Stapelzeiger/airdata-probe/Readme.md

# Airdata Probe

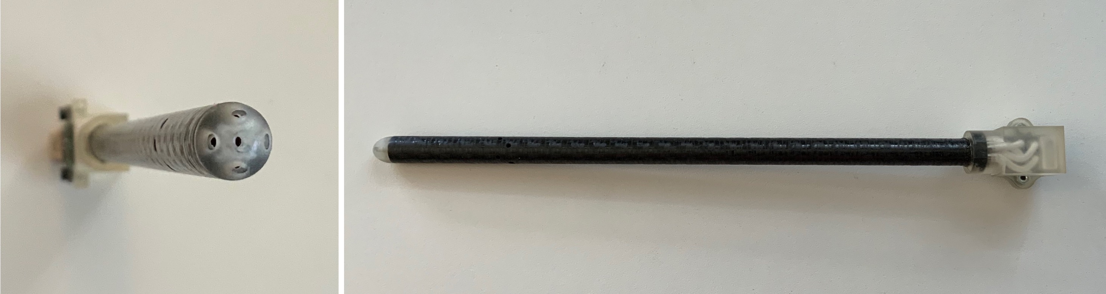
[picture p1: pictures/top_side.jpg]
Side view


## Ports

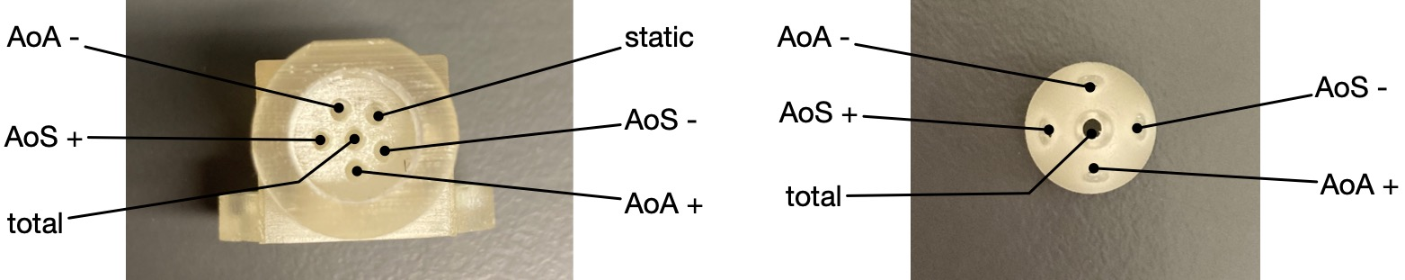
[picture p2: pictures/ports.jpg]
ports


## PCB

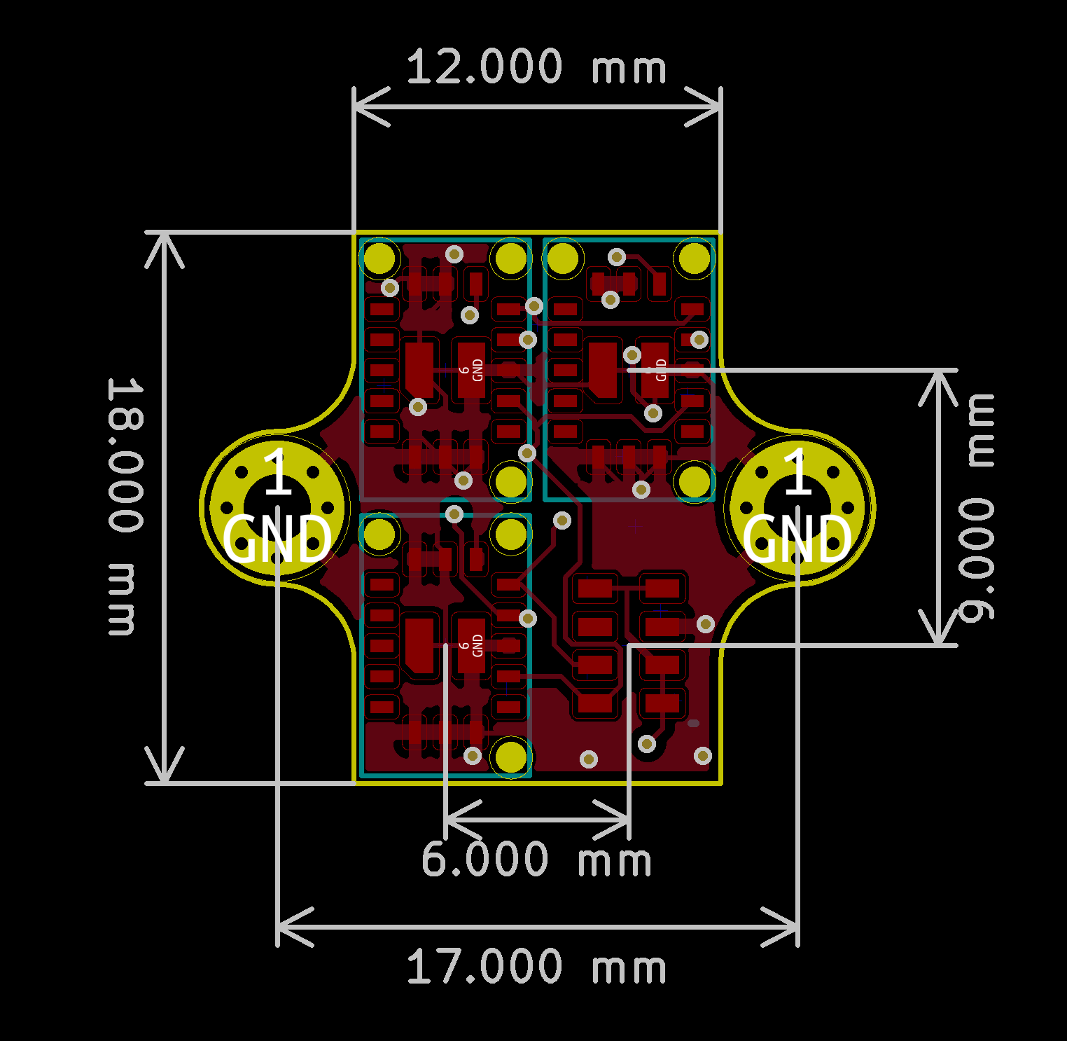
[picture p3: pcb/dimensions.png]
PCB


[Schematic](pcb/airdata.pdf)
