Stapelzeiger/airdata-probe/cad/parts.txt

Stainless Steel Tubing, 304 Stainless Steel, 0.072" OD, 0.005" Wall Thickness, 1 Foot Long 5560K36 https://www.mcmaster.com/nav/enter.asp?partnum=5560K36

o-ring https://www.mcmaster.com/9452K311/

Tygon PVC Clear Tubing 1/16" ID, 1/8" OD, 25 ft. Length 6516T11 https://www.mcmaster.com/nav/enter.asp?partnum=6516T11

Carbon Fiber Roll Wrapped Twill Tube ~ 0.313" ID x 24", Thin Wall Gloss Finish
https://dragonplate.com/carbon-fiber-roll-wrapped-twill-tube-0313-id-x-24-thin-wall-gloss-finish

Carbon Fiber Roll Wrapped Twill Tube ~ 0.25" ID x 24", Thin Wall Gloss Finish
https://dragonplate.com/carbon-fiber-roll-wrapped-twill-tube-025-id-x-24-thin-wall-gloss-finish
