Stapelzeiger/airdata-probe/cad/pressure_board.SLDASM

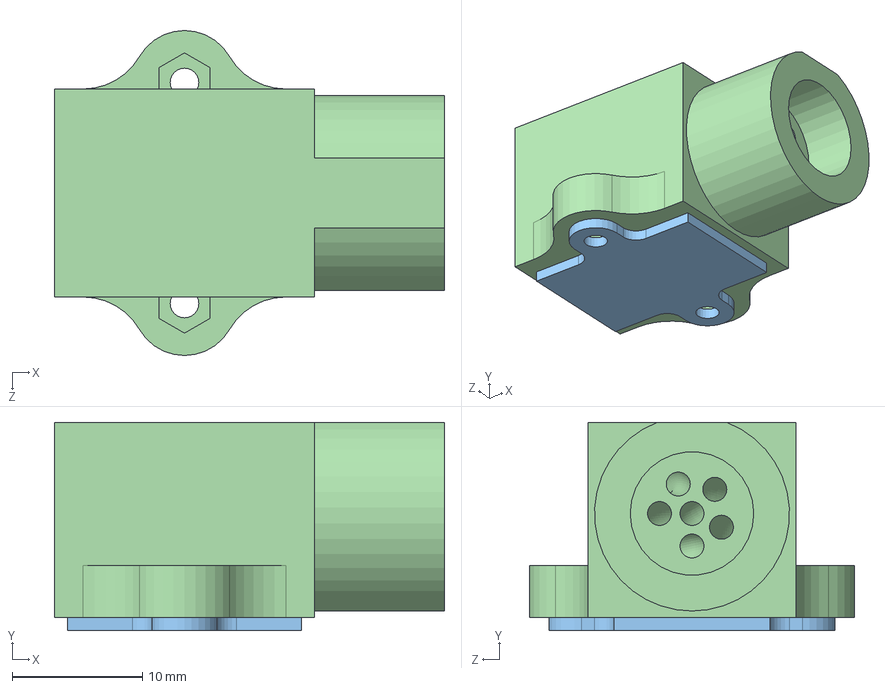
[picture p4: CAD file, 2022-06-05]
cad/pressure_board.SLDASM
30.0 x 16.0 x 25.0 mm
sdp3x x 3
static_pressure_connector
PCB^pressure_board
Part2^pressure_board
