Stapelzeiger/airdata-probe/cad/flow-sensor.SLDASM

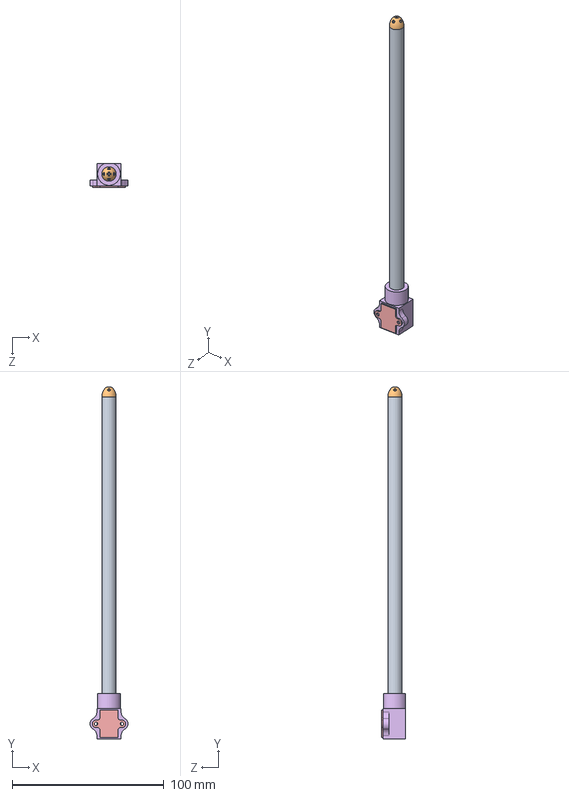
[picture p5: CAD file, 2022-06-05]
cad/flow-sensor.SLDASM
25.0 x 231.7 x 16.0 mm
flow-sensor-tube
flow-sensor-tip
sdp3x x 3
static_pressure_connector
PCB^pressure_board
Part2^pressure_board
