Stapelzeiger/airdata-probe/cad/static_pressure_connector.SLDPRT

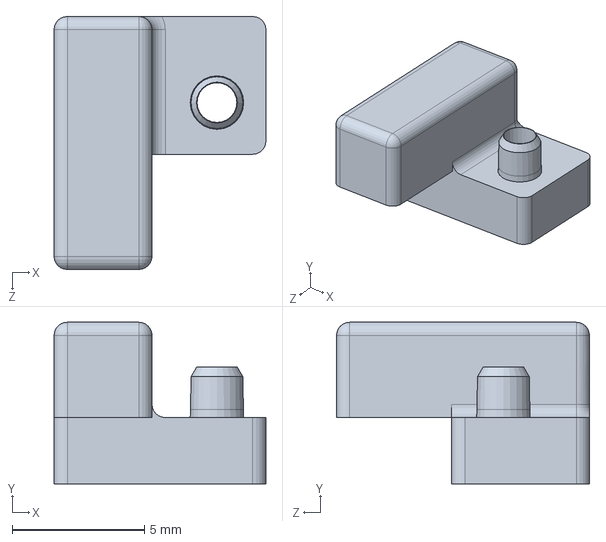
[picture p6: CAD file, 2022-06-05]
cad/static_pressure_connector.SLDPRT
8.00 x 6.10 x 9.55 mm
