Stapelzeiger/airdata-probe/pcb/3dmodels/SM04B-GHS-TB.stp

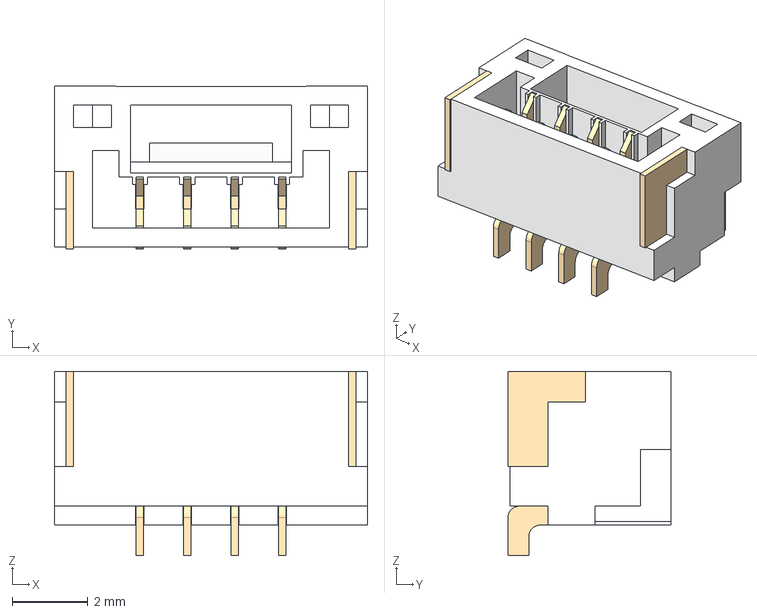
[picture p7: CAD file, 2022-06-05]
pcb/3dmodels/SM04B-GHS-TB.stp
8.25 x 4.30 x 4.85 mm
