Stapelzeiger/airdata-probe/cad/flow-sensor-tip.SLDPRT

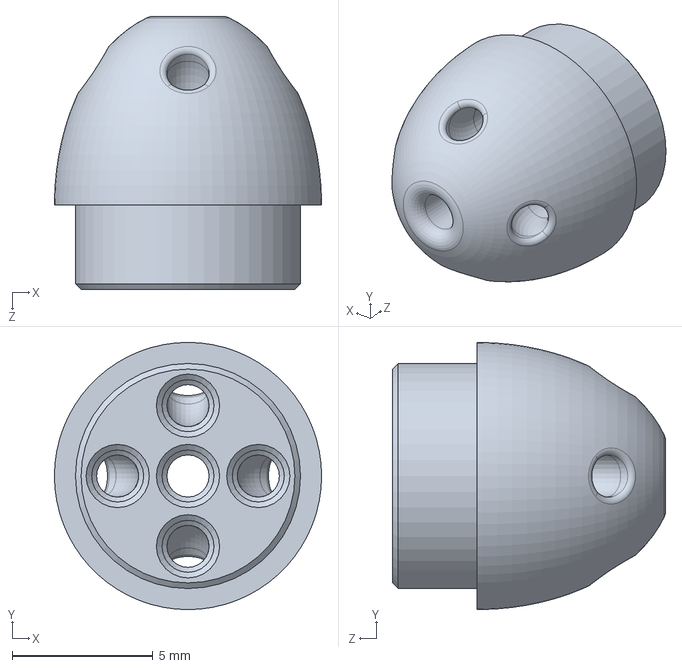
[picture p8: CAD file, 2022-06-05]
cad/flow-sensor-tip.SLDPRT
9.50 x 9.50 x 9.71 mm
