Stapelzeiger/airdata-probe/cad/sdp3x.SLDPRT

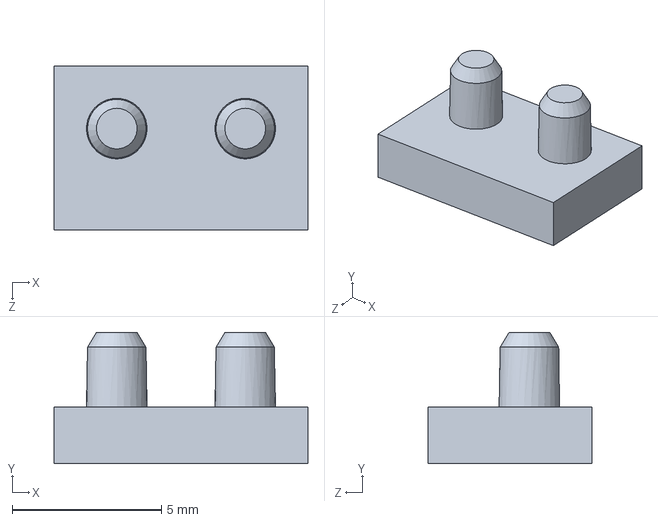
[picture p9: CAD file, 2022-06-05]
cad/sdp3x.SLDPRT
8.50 x 4.40 x 5.50 mm
