Stapelzeiger/airdata-probe/cad/flow-sensor-tube.SLDPRT

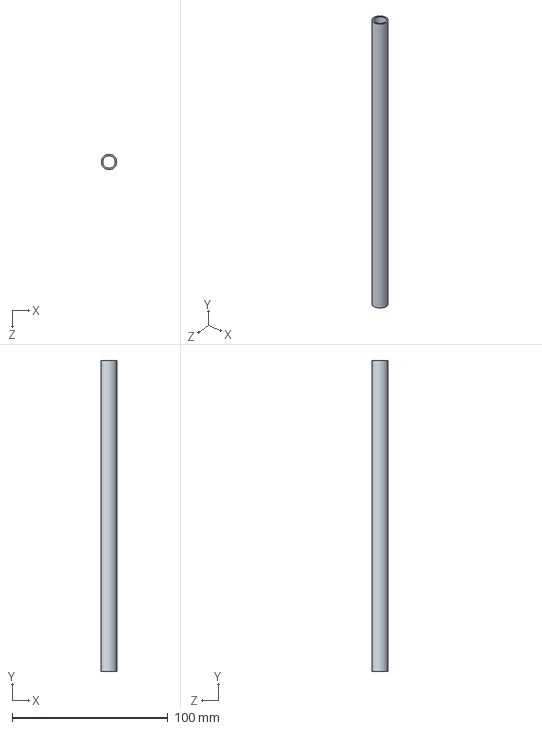
[picture p10: CAD file, 2022-06-05]
cad/flow-sensor-tube.SLDPRT
10.0 x 200.0 x 10.0 mm
