Stapelzeiger/airdata-probe/cad/pressure_adapter.STL

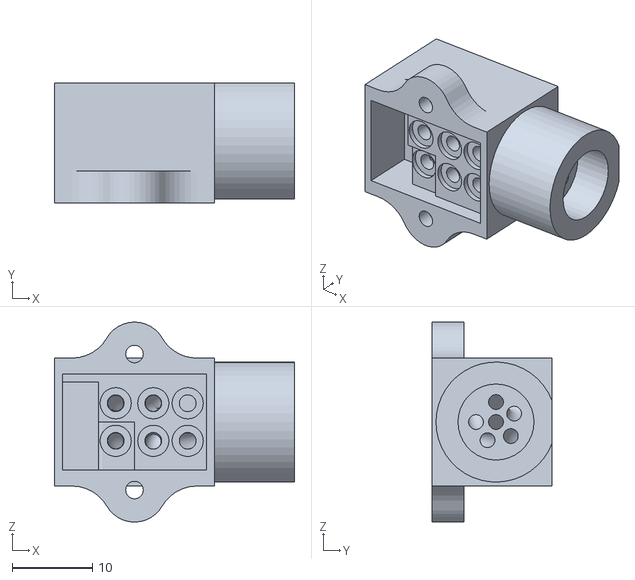
[picture p11: CAD file, 2022-06-05]
cad/pressure_adapter.STL
30.0 x 15.0 x 25.0
