Stapelzeiger/airdata-probe/(list of files, cad)

Other CAD files:
cad/flow-sensor-tip.STL
cad/static_pressure_connector.STL
