Stapelzeiger/airdata-probe/pcb/airdata.pdf

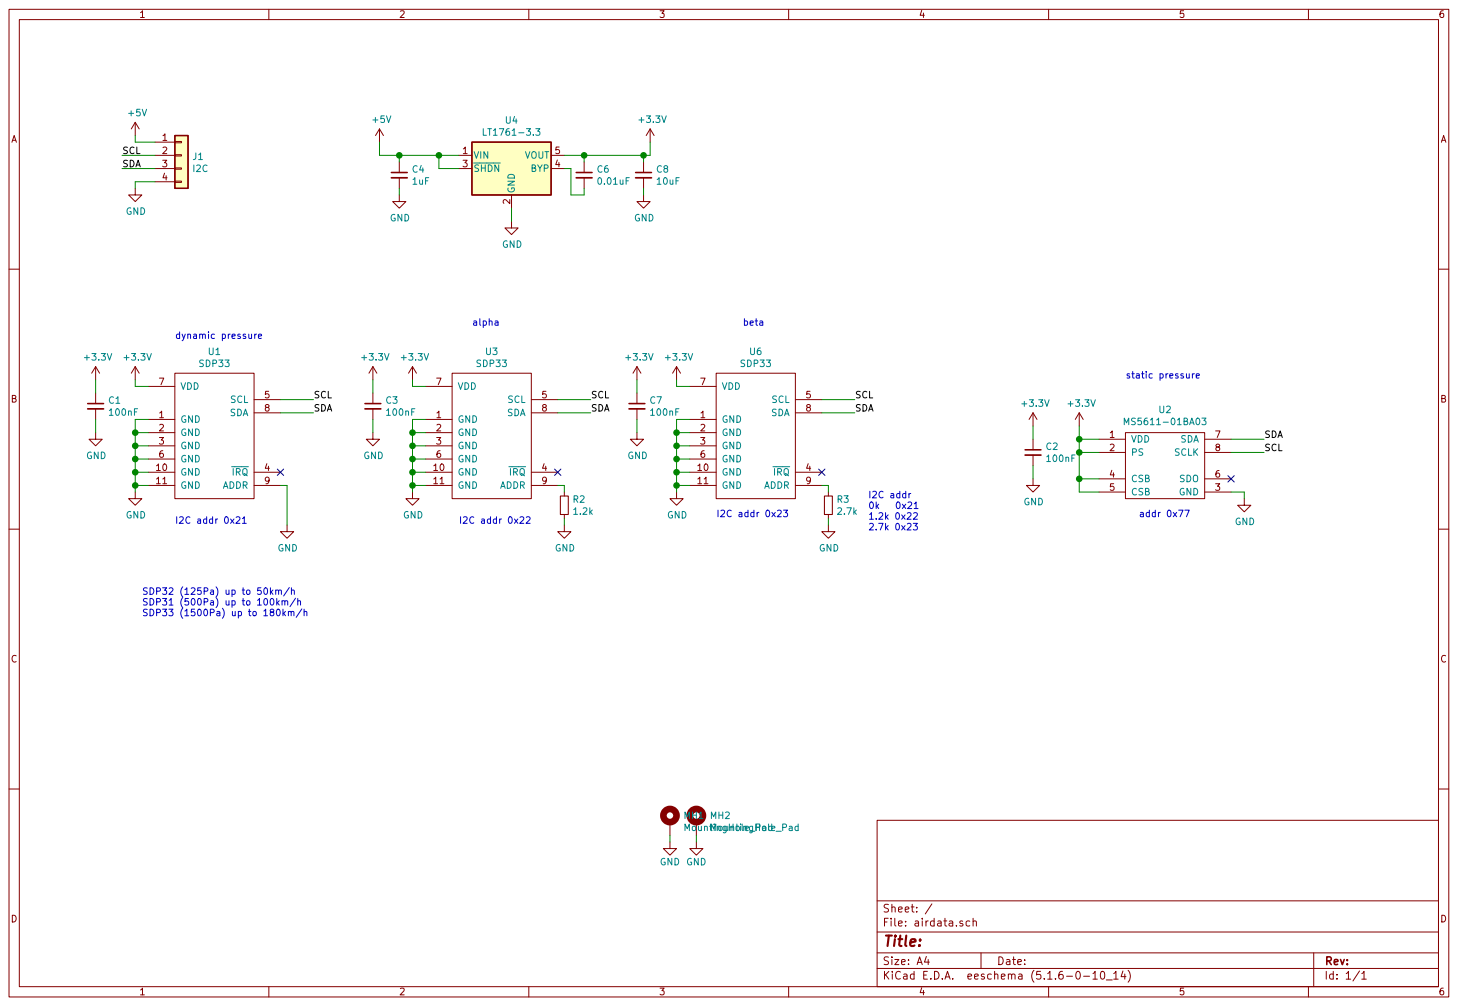
[picture p12: page 1]

Id: 1/1 Title: File: airdata.sch Sheet: /
