Stapelzeiger/airdata-probe/pcb/airdata.kicad_pcb

## KiCad design pcb/airdata.kicad_pcb (2022-06-05)

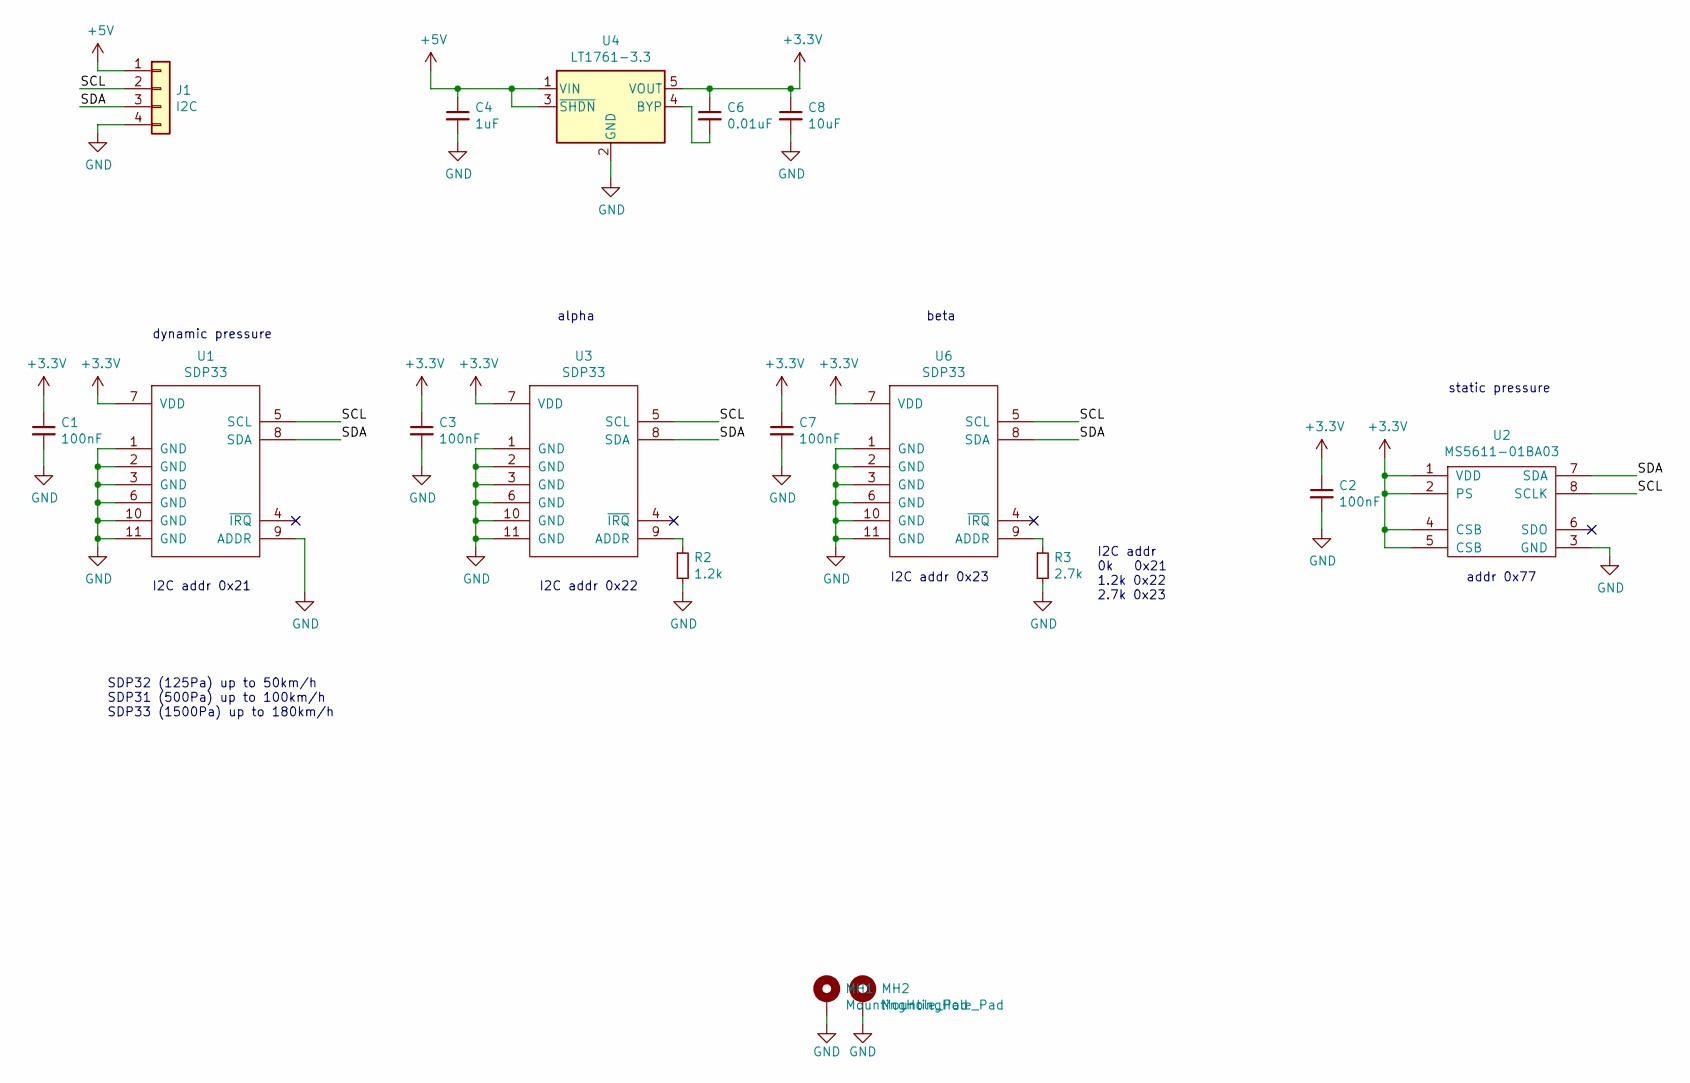
[picture p13: schematic airdata.sch]

Parts:
C1, C2, C3, C7: 100nF; C_0603_1608Metric
C4: 1uF; C_0603_1608Metric
C6: 0.01uF; C_0603_1608Metric
C8: 10uF; C_0603_1608Metric
J1: I2C; JST_GH_SM04B-GHS-TB_1x04-1MP_P1.25mm_Horizontal
MH1, MH2: MountingHole_Pad; MountingHole_2.2mm_M2_Pad_Via
R2: 1.2k; R_0603_1608Metric
R3: 2.7k; R_0603_1608Metric
U1, U3, U6: SDP33; SDP3x
U2: MS5611-01BA03; MS5611-01BA
U4: LT1761-3.3; TSOT-23-5

Connections:
+3V3: C1.1, C2.1, C3.1, C6.1, C7.1, C8.1, U1.7 (VDD), U2.1 (VDD), U2.2 (PS), U2.4 (CSB), U2.5 (CSB), U3.7 (VDD), U4.5 (VOUT), U6.7 (VDD)
+5V: C4.1, J1.1, U4.1 (VIN), U4.3 (~SHDN)
/SCL: J1.2, U1.5 (SCL), U2.8 (SCLK), U3.5 (SCL), U6.5 (SCL)
/SDA: J1.3, U1.8 (SDA), U2.7 (SDA), U3.8 (SDA), U6.8 (SDA)
GND: C1.2, C2.2, C3.2, C4.2, C7.2, C8.2, J1.4, MH1.1, MH2.1, R2.2, R3.2, U1.1 (GND), U1.2 (GND), U1.3 (GND), U1.6 (GND), U1.9 (ADDR), U1.10 (GND), U1.11 (GND), U2.3 (GND), U3.1 (GND), U3.2 (GND), U3.3 (GND), U3.6 (GND), U3.10 (GND), U3.11 (GND), U4.2 (GND), U6.1 (GND), U6.2 (GND), U6.3 (GND), U6.6 (GND), U6.10 (GND), U6.11 (GND)
unnamed: C6.2, U4.4 (BYP)
unnamed: R2.1, U3.9 (ADDR)
unnamed: R3.1, U6.9 (ADDR)

Notes on the sheet:
I2C addr 0k 0x21 1.2k 0x22 2.7k 0x23
I2C addr 0x23
addr 0x77
alpha
beta
dynamic pressure
static pressure
SDP32 (125Pa) up to 50km/h SDP31 (500Pa) up to 100km/h SDP33 (1500Pa) up to 180km/h
I2C addr 0x22
I2C addr 0x21

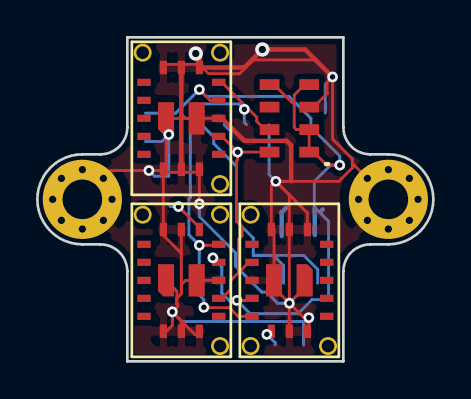
[picture p14: board airdata.kicad_pcb from above]

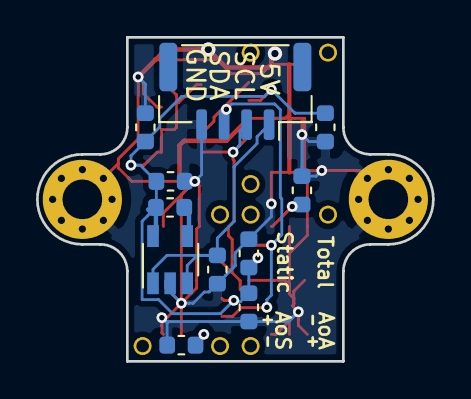
[picture p15: board airdata.kicad_pcb from below]

Board: 2 copper layers, 22.0 x 18.0 mm, 17 parts (11 on the bottom side), 8 nets.
